yuxuan-518/piezoelectric-floor-tile/docs/process-reports/README.md

# Process summaries and laboratory reports

These Chinese documents record the team's development process. They include exploratory explanations, simulation notes, and proposed tests as well as experimental observations. A proposed test in a report is not evidence that it was completed.

The [current experiment definitions](../experiments.md) incorporate the team's November 4 clarifications: A is the one-disc adaptation of V1, B is V3, and the A/B storage capacitor is 4.7 μF. Older eight-disc V1 and 2.2 μF configurations remain historical records.

| Document | Scope |
| --- | --- |
| [Design iterations, October 31](design-iterations-2026-10-31.pdf) | 31-page project overview with V1–V3 development, measurements, simulation discussion, and unresolved items at that date |
| [Circuit troubleshooting, June 1](circuit-failure-and-troubleshooting-2026-06-01.docx) | Unlit LED, candidate causes, and a proposed diagnostic sequence |
| [Bridge continuity and LED trials, June 2](bridge-continuity-and-led-trials-2026-06-02.md) | Soldered bridge continuity and unsuccessful breadboard LED attempt |
| [Bridge and parallel wiring, June 4](bridge-and-fourteen-disc-wiring-2026-06-04.pdf) | Five bridges, fourteen-disc wiring, and connection problems; not quantitative output data |
| [Capacitor and LED tests, June 12](node-voltage-capacitor-and-led-tests-2026-06-12.pdf) | Node-voltage measurements and capacitor comparison during circuit replication |
| [V2 candidate selection](v2-simulation-candidate-selection-2026-07-02.md) | Reading simulated event classifications and mass/stiffness candidates |
| [V2 modeling review](v2-modeling-and-data-processing-review-2026-07-02.md) | Event-driven mechanics, measured displacement input, preprocessing, and boundary corrections |
| [V2 spring specifications](v2-spring-procurement-specifications.txt) | Procurement targets and tolerances, rather than measured spring rates |
| [V2 model and experiment plan](v2-theory-comparison-and-measurement-plan-2026-08-01.docx) | Eight-module model, continuous-contact baseline proposal, capacitor measurement and statistical plan |
| [V3 contact-force method](v3-center-punch-contact-force-method.pdf) | Method to estimate peak contact force from contact speed, effective mass and stiffness; not a measured force result |
| [Reference links](reference-paper-and-lab-log-links.txt) | Reference paper and online laboratory-log link |

The V3 force PDF appeared twice under different source filenames with identical bytes; one copy is included. File contents are retained. Historical Markdown reports can contain local figure paths from the original working environment; the relevant current V2 plots are available in [simulation/v2/figures/](../../simulation/v2/figures/).
