yuxuan-518/piezoelectric-floor-tile/assets/images/README.md

# Images

| Folder | Contents |
| --- | --- |
| [v1/](v1/) | Initial glue-contact replication and revised eight-disc sponge sandwich |
| [v2/](v2/) | Concept sketch, CAD geometry, structural-analysis setup, and assembled tile |
| [v3/](v3/) | Assembled V3 prototype, printed components and springs, center-punch section drawing, and animation preview |
| [equipment/](equipment/) | Camera selection reference, separate from prototype images |
| [../figures/](../figures/) | A/B measurement figures generated from the displayed-value snapshot |

A V2 assembled-tile photo originally outside the V2 subfolder is grouped here with the second version. The V1 eight-disc photos illustrate the historical tile, not the later one-disc A comparator. V3 includes physical photographs of the assembled prototype, printed components, and springs, together with a separate mechanism drawing.

## V3 physical photographs

- [IMG_7800](v3/IMG_7800.jpg): component photograph displayed below the experiment videos at the front of the main README.
- [IMG_7799](v3/IMG_7799.jpg): components laid out, displayed in the bottom V3 gallery.
- [IMG_7801](v3/IMG_7801.jpg): components and springs, displayed in the bottom V3 gallery.
- [Assembled prototype, view 1](v3/assembled-1.jpg): placed before IMG_7800 near the front of the main README; source: 组装后1.HEIC.
- [Assembled prototype, view 2](v3/assembled-2.jpg): displayed at the end of the V3 gallery in the main README; source: 组装后2.HEIC.
