yuxuan-518/piezoelectric-floor-tile/assets/videos/README.md

# Videos

| File | What it shows |
| --- | --- |
| [Open-circuit test — 5 presses (IMG_7791)](https://github.com/user-attachments/assets/d7630d02-6c3a-4639-a595-0fe88d64db57) | Manual actuation with the open-circuit voltage waveform shown on the oscilloscope |
| [4.7 μF capacitor test — 10 presses (IMG_7792)](https://github.com/user-attachments/assets/3c00106a-591d-475d-8370-14c3a34ea7ed) | Manual actuation with a 4.7 μF capacitor connected |
| [Phase 0 LED demonstration](phase0-piezo-led-demonstration.mp4) | Tapping piezoelectric discs to light an LED during circuit replication |
| [V2 Fusion static analysis](v2-fusion-static-analysis.mp4) | Center-loaded structural simulation; [WEBM alternative](v2-fusion-static-analysis.webm) |
| [V2 floor-displacement simulation](v2-floor-displacement-simulation.mp4) | Simulation video identified by the team as the second design |
| [V3 center-punch mechanism](v3-center-punch-mechanism.mp4) | Animation of energy storage, trigger alignment, and release |
| [V3 center-punch cutaway](https://github.com/user-attachments/assets/8360fb55-114a-463f-ac32-afa692dda5be) | Additional cutaway animation of the center-punch mechanism; [repository copy](v3-center-punch-cutaway.mp4) |

The simulation and mechanism videos illustrate designs rather than instrumented physical test results. Original experimental displacement and capacitor videos are packaged with the [historical data release](https://github.com/yuxuan-518/piezoelectric-floor-tile/releases/download/project-archive-2026-11-04/historical-v1-v2-measurements.zip).

No V1 mechanism/CAD animation was supplied; V1 is documented with photos and laboratory records.
