yuxuan-518/piezoelectric-floor-tile/docs/process-reports/bridge-continuity-and-led-trials-2026-06-02.md

# 6.2 原型电路复刻实验报告

目标

* 4个1n60p 二极管桥式整流电路  
* 电容储能  
* 尝试驱动黄色LED

材料清单：

| 压电陶瓷片 | 未使用 |  |
| :---- | :---- | :---- |
| 1N60P 二极管x4 | 使用 | 通过电焊组成整流桥并且通过了万用表测试。 |
| 100uF / 25V 电解电容  | no |  |
| 150 ohm 电阻 | no |  |
| 黄色LED | no |  |
|  |  |  |
| 电焊器组 | 使用 |  |
| 万用表 | 使用 |  |

实验结果：进行中  
Team A \-  xsx ysq

* 通过电焊组成整流桥   
  * 已通过万用表测试  
* 学习了关于整流桥的基本电路原理

Team B \- whj

* 用其他论文中的相似电路用面包板实现电路工作点亮LED-失败 	— 行不通  
* 学习相关电子元件的作用，了解现有整流桥的电子流向

下次实验方向

* 完成整流桥，电容，压电片，形成完整电路  
* 尝试点亮LED  
* 明白其电路图的工作原理
