yuxuan-518/piezoelectric-floor-tile/docs/process-reports/reference-paper-and-lab-log-links.txt

Selim, K.K., Yehia, H.M., & Saleeb, D.A. (2024). Energy Harvesting Floor Tile Using Piezoelectric Patches for Low-Power Applications. Journal of Vibration Engineering & Technologies, 12, 8613-8622. https://doi.org/10.1007/s42417-024-01379-z
Online lab report (June 2): https://docs.google.com/document/d/1Qe5F5qePgIK7pGi6XQBFLI0McOi2MfYt_HB0X1i6unA
