yuxuan-518/piezoelectric-floor-tile/CREDITS.md

# Contributors

This project was developed by Shaoxuan Xiong, Shuoqi Yang, and Wenhao Jia. The original contributions were clarified on November 5, 2026; all three contributor descriptions were revised on November 8, 2026. **Shaoxuan Xiong led the research and is the first author of the project manuscript.**

<table>
<tr><td>
<h2>Shaoxuan Xiong</h2>
<ul>
<li>As the first author of the project manuscript and research lead, I led the development of the research idea, workflow, and methods, and coordinated the project's experimental and analytical work.</li>
<li>I was responsible for early circuit assembly, capacitor selection, and V1/V2 measurements, assessed data quality and the plausibility of the results, and led the overall data analysis.</li>
<li>During V2 development, I led mechanism development, Python simulation, and spring-parameter selection, and revised and checked the physical model assembled by Shuoqi Yang.</li>
<li>During the V3 stage, I reviewed the data independently collected by Wenhao Jia and Shuoqi Yang and completed all data analysis and figure preparation.</li>
<li>For the manuscript, I established the overall structure and line of argument, then revised, integrated, and refined the initial draft to produce the final manuscript.</li>
</ul>
</td></tr>
</table>

<table>
<tr><td>
<h2>Shuoqi Yang</h2>
<ul>
<li>Participated in measuring, recording, and transcribing V2 and V3 experimental data, and analyzed the V2 data by organizing the measurements and comparing output across tests to support subsequent structural revisions and discussion of the results.</li>
<li>For the V2 motion study, measured and transcribed the displacement of the upper wooden plate driven by footsteps, providing measured motion inputs for simulation.</li>
<li>Was responsible for CAD modeling of V2 modular components, representing the mechanical parts and their structural relationships for assembly and design discussions.</li>
<li>In the V3 stage, led the organization of the physical formulas, including the quantities and relationships used to analyze mechanism motion and contact forces.</li>
<li>Also carried out circuit connection and soldering to support prototype construction and experimental measurements.</li>
</ul>
</td></tr>
</table>

<table>
<tr><td>
<h2>Wenhao Jia</h2>
<ul>
<li>Wrote the first manuscript draft according to the established outline, organizing the design evolution, experimental methods, and research results into initial sections for subsequent discussion and revision.</li>
<li>Participated in measuring and recording V2 and V3 experimental data and assisted with transcription.</li>
<li>For the V2 motion study, recorded and transcribed displacement measurements of the upper wooden plate driven by footsteps to support subsequent data processing and simulation.</li>
<li>Was responsible for V2 CAD assembly modeling, bringing the component models together into a complete assembly, and produced force-analysis animations to illustrate structural relationships and loading.</li>
<li>In the V3 stage, participated in collaborative mechanism design and carried out the related CAD modeling and motion-animation work to illustrate the mechanism's motion and triggered release.</li>
</ul>
</td></tr>
</table>

## Prototype reference

The mechanical starting point was the prototype in Selim, Yehia and Saleeb (2024), [doi:10.1007/s42417-024-01379-z](https://doi.org/10.1007/s42417-024-01379-z). The sponge interface, subsequent mechanisms, and experiments in this repository document this team's development from that starting point.
