yuxuan-518/piezoelectric-floor-tile/assets/images/v3/center-punch-cutaway-preview.png

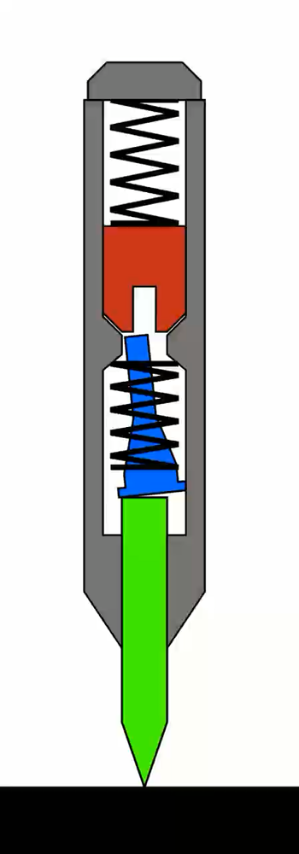
assets/images/v3/center-punch-cutaway-preview.png
