yuxuan-518/piezoelectric-floor-tile/cad/v3/center-punch-assembly.stl

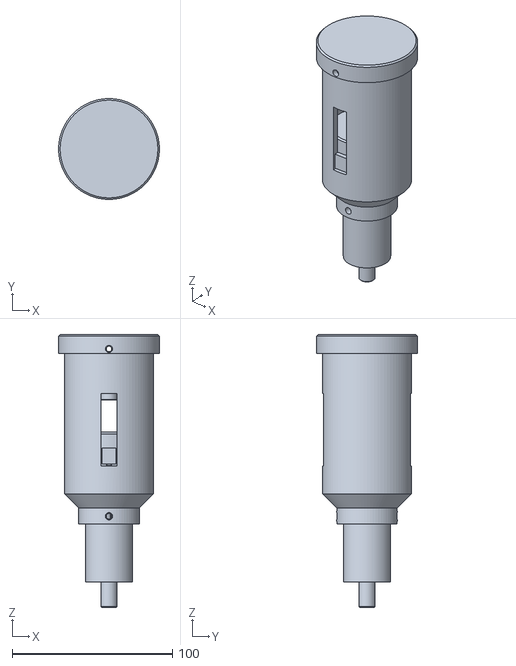
[picture p40: CAD file, 2026-11-05]
cad/v3/center-punch-assembly.stl
63.0 x 63.0 x 170.5
