yuxuan-518/piezoelectric-floor-tile/cad/components/impactor.stl

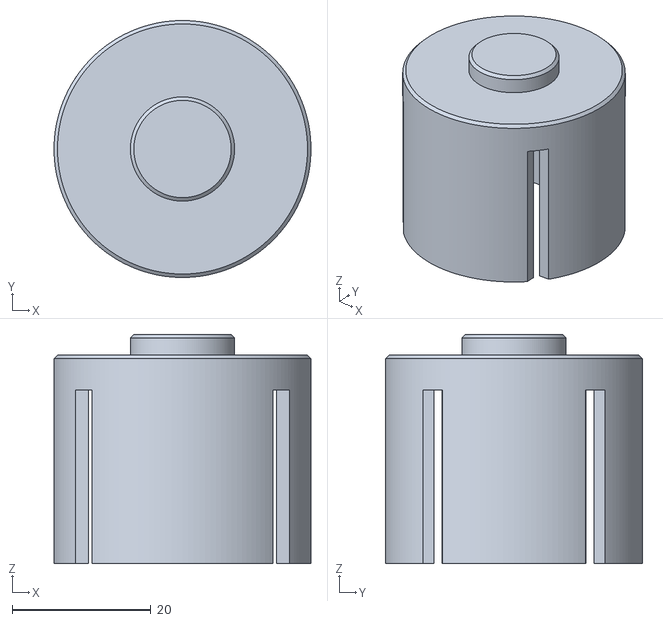
[picture p41: CAD file, 2026-11-05]
cad/components/impactor.stl
37.0 x 37.0 x 33.0
