yuxuan-518/piezoelectric-floor-tile/docs/process-reports/bridge-and-fourteen-disc-wiring-2026-06-04.pdf

# 发电地板项目实验报告

日期：2026年6月4日
实验人员：熊少轩，杨烁琪，贾文浩（排名不分先后）

今日项目进度：
- 焊接完成了5个整流桥
- 整理了压电片部分内容，将14个压电片并联并，通过万用表检验发现电路完善 ，各个部分正常通电

项目问题：
- 由于并没有对数据进行分析仅仅测试电路是否流通，所以未判断增加被施加力 的压电片数量是否会按照理论实现电流增大
- 电焊技术不到位，有些地方的连接不稳定，会出现压电片和主干电线的连接断 开（直接断开或通电异常）的情况
- 未记录任何实验数据

明日计划：
- 完成六个不同的整流桥和电容连接方式（1）
- 将压电发电部分改成灵活拆卸的样式（2）
- 分别调试（1）和（2），确认正常之后连接看整体是否正常输出电流
