yuxuan-518/piezoelectric-floor-tile/docs/experiments.md

# A/B measurements

## Structures and circuit

| Item | Confirmed condition |
| --- | --- |
| A | V1-derived sponge structure with one piezoelectric disc |
| B | V3 center-punch structure, using one disc for the count-matched comparison |
| Historical V1 tile | Eight parallel discs; a different configuration from A |
| Quasi-open-circuit measurement | Before rectification, using the oscilloscope input |
| Capacitor | 4.7 μF for the current A/B experiment |
| Single-step initial state | Capacitor discharged before each step; recorded V0 values are zero at displayed precision |
| Attenuation | Matching oscilloscope/probe settings confirmed by the team |

The oscilloscope presents a finite input impedance, hence the retained term **quasi-open-circuit**. Voltage measurements under this condition are not delivered load energy.

## Stepping protocol and comparison limits

The team confirmed the following conditions on November 5, 2026:

| Condition | Recorded protocol |
| --- | --- |
| Operator, footwear, and stepping location | Same person, same shoes, and a fixed stepping location for A/B |
| Input motion | Normal stepping; displacement/travel and stepping speed or cadence were neither controlled nor recorded |
| Test order | A/B alternation; no randomization is claimed |
| Piezoelectric disc model | Same model for A/B; exact specification is not recorded in this snapshot |
| Rectifier bridge | Same bridge for A/B; exact specification is not recorded in this snapshot |
| Readout timing | Same post-step waiting time for A/B; its numerical duration is not recorded in this snapshot |

Alternating order, a shared operator, matching component types, and matching readout delay reduce some procedural differences, but do not establish equal force, displacement, or mechanical work at each step. The results describe capacitor storage in these normal-stepping tests. They do not isolate mechanism-only effects or establish an electrical conversion-efficiency gain. Readout timing matters because stored voltage can decay after a step.

For a future controlled comparison, record force and displacement together to estimate input work, specify the post-step readout delay, and record the disc and rectifier specifications. Keep those future measurements separate from this existing dataset. Alternation alone does not establish paired observations: the copied worksheet has no event log linking specific A and B steps.

## Stored-energy calculation

For each trial:

\[
\Delta E_C = \frac{1}{2}C\left(V_1^2 - V_0^2\right).
\]

With C = 4.7 μF and voltage in volts, ΔE in μJ equals `2.35 * (V1**2 - V0**2)`. This is the net increase in capacitor energy over the measurement window. It is not the total mechanical energy supplied or all electrical energy generated by the disc.

The copied voltage display for the single-step sheet has one decimal place. The workbook's recorded energy can have been calculated from more precise cell values. Re-squaring the rounded voltage can therefore disagree with its recorded energy. The repository keeps both displayed quantities and calculates descriptive summaries from the **recorded energy** column. It verifies that these energy values fit within the voltage-rounding intervals for a 4.7 μF capacitor.

## Snapshot and sample counts

The [live workbook](https://1drv.ms/x/c/ec731eaab7075a35/IQBu0pYTxfz4QIeSvFwY5F9VATk93ZKyLGgmgde4zelluMU) was read on **November 4, 2026** using the read-only Copy command in Excel Online. The local JSON and CSV files are snapshots of formatted displayed values, not a complete XLSX download, formula export, or full-precision instrument export.

| Sheet | Imported region | Interpretation |
| --- | --- | --- |
| 准开路 | A1:J21 and A24:J44 | A and B, three column groups of 20 steps each |
| 单次电容 | A1:P23 and A24:P46 | A and B, five adjacent V0/V1/Ec groups of 20 steps each |
| 多次电容_5 | A1:H12 | Five charging runs per structure, five steps per run |
| 多次电容_10 | A1:H12 | Five charging runs per structure, ten steps per run |
| 多次电容_20 | A1:H12 | Five charging runs per structure, twenty steps per run |

The unlabelled flattened columns on the right of the single-step sheet are not imported as extra trials. Group/trial indices preserve the worksheet organization; matching row numbers are not assumed to establish statistically paired A/B trials.

## Difference from the older summary

The “条件” sheet still describes three groups and contains earlier single-step summary values. Its A energy means (roughly 2.3–2.5 μJ) differ from the current labeled single-step blocks (roughly 10–13 μJ per group). Its B values also differ from the expanded current blocks. Consequently, its earlier improvement figures are not used as current results.

The repository's [summary.csv](../data/ab-comparison/summary.csv) is recomputed from the current labeled blocks. It gives approximately **11.6 μJ for A and 72.5 μJ for B**, with a ratio of means around **6.23**. This is a descriptive comparison of the stored-energy records. The chart shows sample SD rather than confidence intervals. Repeated steps from one person are not independent participants; test order alternated and mechanical input work was not measured.

The [formula review workbook](../data/ab-comparison/ab-formula-review-2026-11-05.xlsx) supplies current summary formulas and a separate calculation from rounded voltage, including its rounding interval. It is derived from the November 4 displayed-value snapshots. It does not preserve the live workbook's original formulas or hidden precision, and does not replace an original XLSX archive. The older online “条件” sheet has not been edited.

The condition sheet mentions 50-step charging and a 150-cycle durability test. No separate populated records for those tests were identified in the six available sheets, so those tests are not presented as completed results.

## Historical records

The historical release archive contains the separately documented eight-disc V1 and V2-era oscilloscope images, capacitor recordings, and motion videos. Older reports discuss a 2.2 μF circuit; that historical value is not substituted for the confirmed 4.7 μF A/B capacitor. Original V1 images show an X10 scope setting and V2 images X1; the archived notes preserve this distinction.

The team confirmed that A/B attenuation settings match. This does not identify the exact circuitry or sensor count in every older historical image. Historical shots are therefore not silently merged into the A/B dataset.
