yuxuan-518/piezoelectric-floor-tile/simulation/v2/results/measured_v3_paper_candidates.csv

# generated_at: 2026-07-02 21:46:52
# source: measured_v3_sim_sweep.csv preprocess=clamp 子集
# strong_candidate: max_rel_speed_ms >= 0.5
# moderate_candidate: 0.1 <= v < 0.5
# borderline_candidate: 0.05 <= v < 0.1
# below_threshold: v < 0.05（有效但不纳入主结论）
# time_precision_note: 100Hz 数据，Δt=10ms，样条插值。
# detach_time_s 的 1e-7 精度是数学精度，非物理精度（物理精度≤5ms）。
# 论文引用请用 detach_time_paper_s（精确到 1ms），并注明'约 XXX ms'。
# note: recommended 字段来自参数化模型语境，在此仅作参考，不作论文依据。
trial | preprocess | smooth | m_g | k_Nmm | k_Nm | e | T_up_crit_ms | detach | detach_time_s | N_at_detach | impact_count | impact_times_s | max_rel_speed_ms | max_impact_energy_mJ | risky | recommended | data_end_s | detach_margin_to_end_s | is_tail_detach_20ms | is_early_detach_20ms | is_valid_detach_for_paper | n_clamped_pts | candidate_grade | detach_time_paper_s
fast_3 | clamp | none | 100 | 0.5 | 500 | 0.5 | 31.4 | True | 0.285531 | 0.0 | 2 | [0.3039177, 0.3544288] | 1.16857 | 68.27779 | False | True | 0.32 | 0.03447 | False | False | True | 2 | strong | 0.28600000000000003
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
