yuxuan-518/piezoelectric-floor-tile/simulation/v2/results/measured_v3_sim_sweep.csv

# version: measured_v3
# generated_at: 2026-07-02 21:45:48
# e_fixed: 0.5
# smooth_savgol: window=5 polyorder=2
# smooth_butter: cutoff_hz=10 order=2
# t_end_sim: 1.0s
# preprocess_raw: 保留原始数据（含末尾负值）
# preprocess_clamp: 峰后首次 y<=0 起截为 0
# boundary_fix_v2: t>t_max → y=last | v=0 | a=0
# is_tail_detach_20ms: detach_time_s > data_end_s - 0.02s
# is_early_detach_20ms: detach_time_s < data_start_s + 0.02s
# is_valid_detach_for_paper: detach AND NOT tail AND NOT early AND impact_count>0
# 论文主结论：preprocess=clamp + is_valid_detach_for_paper=True
# 敏感性附录：preprocess=raw 对比
trial | preprocess | smooth | m_g | k_Nmm | k_Nm | e | T_up_crit_ms | detach | detach_time_s | N_at_detach | impact_count | impact_times_s | max_rel_speed_ms | max_impact_energy_mJ | risky | recommended | data_end_s | detach_margin_to_end_s | is_tail_detach_20ms | is_early_detach_20ms | is_valid_detach_for_paper | n_clamped_pts
fast_1 | raw | none | 50 | 0.5 | 500 | 0.5 | 22.2 | False |  |  | 0 | [] | 0.0 | 0.0 | False | False | 0.32 |  | False | False | False | 0
fast_1 | raw | none | 50 | 1.0 | 1000 | 0.5 | 15.7 | False |  |  | 0 | [] | 0.0 | 0.0 | False | False | 0.32 |  | False | False | False | 0
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
