yuxuan-518/piezoelectric-floor-tile/docs/process-reports/v2-theory-comparison-and-measurement-plan-2026-08-01.docx

压电地板弹簧-撞击能量采集系统

理论模型、能量转换流程、对比实验与数据测量计算完整报告

研究对象 | 8模块弹簧-撞击式压电能量采集地板
核心问题 | 多次分离-再撞击是否提高单次踩踏净电容储能
报告性质 | 降复杂度、保执行性；实验主导的降阶工程模型
版本日期 | 2026-08-01

核心证据链

板位移 → 弹簧压缩与储能 → 分离/再撞击 → 多个压电脉冲 → 整流 → 电容净储能提升

说明：本报告不把简化模型包装成完整有限元或高保真碰撞仿真。最终性能结论以同步视频、开路波形和电容储能实测为准。

# 1. 报告目的与最终研究问题

本报告把已经确认的实际结构、分段机械模型、电学转换链路、Baseline对比方案、需要直接测量的数据、需要由实测数据计算的量、统计分析以及减少压电片消耗的执行安排统一到一份可直接用于实验和正式技术报告的方案中。

研究问题：New结构中的弹簧-撞击物分离与多次再撞击，是否在相近踩踏条件下，比Baseline产生更多可利用电能？

## 1.1 最主要的结果指标

ΔE_step = 1/2 · C_F · (V_after² - V_before²)

该量应命名为“单次踩踏净电容储能增量”。它不是压电片产生的全部机械-电能，而是经过压电内部损耗、整流桥损耗、导线损耗和电容漏电后，最终留在储能电容中的净增量。New与Baseline使用完全相同电路时，该指标最适合公平对比。

# 2. 已确认的装置结构与建模边界

## 2.1 上板与压电组件

- 上层亚克力板尺寸为455 mm × 610 mm × 2 mm，踩踏位置位于板中心附近。
- 压电片安装在亚克力板下表面，不在装置底部。
- 单个压电模块自上而下依次为：亚克力板下表面、上层海绵、压电陶瓷面、黄铜面、下层海绵、撞击物顶部突起、撞击物、大弹簧、底部支撑/孔结构。
- 压电片边缘以电工胶带在两侧固定于亚克力板下表面，主要工作形式为弯曲。
- 系统共有8个主压电-撞击模块，8片压电片先并联，再接共同的整流桥和2.2 μF储能电容。

## 2.2 主弹簧-撞击模块

- 撞击物位于大弹簧上端，顶部突起朝向下层海绵和压电片。
- 大弹簧没有粘死或机械锁死，只是放置在相应孔内。
- 主模块及其导向孔/导向结构位于四层EPS泡沫中。导向管不应被描述为包裹撞击物，除非实物几何另有确认。
- 设计初始状态为撞击物突起与下层海绵刚好接触：设计间隙g₀=0，且没有额外人为预压。装配后仍需逐模块实测确认。
- 模型中只有在视频确认弹簧底端不离底、不明显滑动且底部支撑位移很小时，才将底端近似视为固定端。

## 2.3 四角限位/回位系统

- 亚克力板四角各有一套限位弹簧和限位导向管。
- 限位弹簧上端粘接在亚克力板四角。
- 限位系统位于上面三层EPS泡沫中；主模块位于四层泡沫中。
- 限位系统限制最大下压行程并帮助上板回升。约25 mm目前应区分为设计值或实测值，正式报告以实测y_max为准。

# 3. 从脚部压力到最终电压的完整流程

1. 脚在亚克力板中心附近施加载荷，上板产生整体下降和局部弯曲。
2. 亚克力板下表面的上层海绵-压电片-下层海绵组件随板向下运动。
3. 下层海绵压到撞击物突起，撞击物向下运动，大弹簧被压缩并储存弹性势能。
4. 压电片在第一次快速加载中弯曲，产生第一组正负电荷/电压脉冲。
5. 脚开始卸载，上板在四角回位结构和自身弹性作用下回升；接触力逐渐减小。
6. 当维持接触所需的法向力降为零后，撞击物与上方组件发生分离。
7. 分离后，撞击物-大弹簧系统进行近似阻尼自由振动。
8. 撞击物向上追上回升的上方组件，重新接触下层海绵并再次弯曲压电片，形成后续电压脉冲。
9. 若剩余机械能足够，分离-再接触可重复多次，脉冲幅值通常逐渐衰减。
10. 8片压电片并联后的交流脉冲经过桥式整流后变为同方向充电电流。
11. 只有足够高的瞬时压电阵列电压才能克服当时的电容电压和二极管压降，使储能电容产生可测的正向电压台阶。
12. 由踩踏前后电容电压平方差计算单次踩踏净电容储能增量。

# 4. 机械模型与公式

统一约定向下为正。对第i个模块，y_p,i为亚克力板/上方压电组件局部位移，y_m,i为撞击物位移，y_b,i为弹簧底端支撑位移。

## 4.1 弹簧压缩量

Δx_i(t) = y_m,i(t) - y_b,i(t)

若底端支撑位移可忽略，则Δx_i≈y_m,i。只有在撞击物与上方组件保持接触、海绵及压电组件相对变形较小、弹簧底端近似静止时，才进一步近似：

Δx_i(t) ≈ y_p,i(t) （仅限接触阶段）

脱离后不得继续使用Δx≈y_p，必须由撞击物自身位移确定弹簧压缩量。

## 4.2 弹簧力与储能

F_s(t) = k · Δx(t)

E_s,max = 1/2 · k · [Δx_max]²

k必须通过独立静态加载试验获得，不能由压电电压反推。E_s,max表示最大压缩时储存在主弹簧中的理论弹性能，不等于最终电能。

## 4.3 间隙、接触与分离

g_i(t) = g_0,i + Δy_m,i(t) - Δy_p,i(t)

- g_i>0：存在间隙，撞击物与上方组件分离。
- g_i=0：刚好接触。
- 理想刚性接触模型不允许g_i<0；若考虑海绵柔性，可定义接触压缩量δ_i=max(0,-g_i)。
- 再接触事件除g_i=0外，还应满足间隙正在闭合，即ġ_i<0。
- 自由振动不是从“松脚瞬间”立即开始，而是从接触法向力N降到0并发生分离之后开始。

## 4.4 分离后的阻尼自由振动

m_eq · z¨ + c · z˙ + k · z = 0

ω_n = √(k / m_eq)

ω_d = ω_n · √(1 - ζ²), T_d = 2π / ω_d

m_eq,exp = k · (1 - ζ²) · (T_d / 2π)²

若实测阻尼比ζ足够小，才可用简化式m_eq,exp≈k(T_d/2π)²。

## 4.5 理论等效质量与校核

m_eq,theory ≈ m_impactor + (1/3) · m_spring

该1/3修正适用于一端近似固定、一端随质量块运动的均匀弹簧。由于实际大弹簧未粘死，必须先通过视频确认其底端不明显离底或滑移。

ε_m = |m_eq,exp - m_eq,theory| / m_eq,exp × 100%

两种估计方法应互相校核，而不是只选一个结果。差异过大时，应检查底端运动、导向摩擦、泡沫支撑变形、周期识别和弹簧非线性。

## 4.6 阻尼比的实测估计

Λ = ln(A_1 / A_2)

ζ = Λ / √(4π² + Λ²)

A₁和A₂应为相邻同方向振动峰值。可对多对峰值分别计算后取平均，降低视频读数误差。

## 4.7 再撞击速度与辅助强度指标

v_p = dy_p/dt, v_m = dy_m/dt

v_rel = |v_m - v_p|

E_impact,index = 1/2 · m_eq · v_rel²

该式仅作为“简化撞击强度指标”，不能称为精确传入压电片的能量，因为上板局部质量、海绵压缩、接触面积和碰撞损失均未完全建模。位移求导前必须先平滑，不能直接对原始视频坐标做简单差分。

# 5. 压电与电路模型

## 5.1 结构级压电关系

Q_i(t) = d_eff,i · F_i(t)

I_i(t) = dQ_i(t)/dt

d_eff是整个压电片-海绵-胶带-边界约束的等效系数。由于压电片主要弯曲，不能直接把材料手册中的d₃₃或d₃₁代入来精确预测电压。没有独立已知力标定时，这两式只用于解释动态载荷如何产生电荷和电流脉冲。

## 5.2 单片与8片并联

单片等效：电流源 I_s,i 与 C_p,i、R_p,i 并联

I_Σ(t) = Σ I_i(t), C_Σ = Σ C_p,i, 1/R_Σ = Σ(1/R_p,i)

并联主要提高可提供的总电荷/电流能力，不是简单把电压放大8倍。若各压电片波形不同步，某些时刻可能发生部分抵消，因此应抽查单片波形与极性。

## 5.3 开路电压

V_oc,i ≈ Q_i / C_p,i ≈ d_eff,i · F_i / C_p,i

该关系可用于趋势解释。开路峰值高不等于实际可储存能量高，因此开路测试只能作为机械机制和多脉冲证据，不能替代储能或负载测试。

## 5.4 整流桥与储能电容

理论瞬时导通条件：|V_P(t)| > V_C(t) + 2V_D

该条件只用于解释整流桥何时导通。V_C随充电过程变化，V_D也随电流变化，所以它不作为实验中“有效峰”的最终计数判据。

C_F · dV_C/dt = I_rect(t) - I_loss(t)

E_C = 1/2 · C_F · V_C²

ΔE_step = 1/2 · C_F · (V_after² - V_before²)

## 5.5 有效充电脉冲定义

ΔV_C,j* = V̄_C,after - V̄_C,before - ΔV_C,drift

若 ΔV_C,j* > max(3σ_VC,noise, ΔV_scope)，则记为1个有效充电脉冲

- 候选台阶前后应使用短时间窗口平均值，而不是单个采样点。
- 同一连续电容台阶内的多个高频振荡合并为一个有效充电脉冲。
- 机械撞击次数N_impact与有效充电脉冲数N_charge必须分开报告，两者不相等是正常结果。

# 6. New与Baseline对比实验设计

## 6.1 New结构

保留大弹簧-撞击物在卸载后的分离、独立振动和多次再撞击机制。

## 6.2 Primary Baseline

采用连续接触控制结构：使用尽可能小的轻预载或柔性保持件，使撞击物在上板回升时仍与下层海绵保持接触，从而显著减少或消除“分离-自由振动-再撞击”，但尽量保留第一次踩下的传力路径。

- New与Baseline必须使用同一块亚克力板、同样8片压电片和位置、相同海绵、胶带、整流桥、储能电容、踩踏位置和测量系统。
- Baseline不得简单拆掉大弹簧、撞击物或换成完全不同的传力柱，否则会同时改变刚度、接触面积和第一次加载。
- 保持件或限位件不得在正常踩踏中形成新的猛烈碰撞。

## 6.3 Baseline附加噪声验证

|ΔV_C,fixture| / |ΔV_C,main| < 5%

|ΔV_C,fixture| ≤ max(3σ_VC,noise, ΔV_scope)

S_main统一采用电容电压增量ΔV_C，不再使用含义模糊的综合信号量。5%是预先规定的工程容许标准，不是普遍物理常数。若保持机构单独产生的电容台阶超过上述判据，应重新固定、减小预载、消除松动或更换柔性约束。

# 7. 需要直接测量的数据

## 7.1 不通过踩踏测量的一次性参数

数据 | 测量方式 | 用途
亚克力板长/宽/厚 | 卡尺或卷尺 | 结构说明；确认实际尺寸
4层EPS厚度及底板厚度 | 卡尺 | 结构与行程边界
主模块/限位导向管尺寸与层位 | 卡尺+实物检查 | 结构说明
大弹簧自由长度、外径、线径、圈数、质量 | 卡尺+电子秤 | 弹簧描述与理论等效质量
撞击物质量、突起直径与偏心量 | 电子秤+卡尺 | 动力学与接触几何
上下海绵尺寸和厚度 | 卡尺 | 接触柔性与装配公差
8片压电片尺寸与每片电容C_p,i | 卡尺+LCR表 | 一致性与并联模型
8片并联总电容C_Σ | LCR表 | 检查C_Σ≈ΣC_p,i
储能电容实际值C_F | LCR表/电容表，至少3次 | 储能公式使用实测值
二极管型号与典型压降 | 数据表+可选实测 | 整流说明
主大弹簧刚度k | 多个已知载荷与位移 | 机械模型核心参数
4根限位弹簧刚度 | 逐根静态加载 | 回位系统一致性

## 7.2 需要实际踩踏/会消耗压电片疲劳寿命的数据

数据 | 符号 | 测量方式 | 主要用途
上板局部位移曲线 | y_p(t) | 同步侧视视频 | 机械输入与踩踏一致性
撞击物位移曲线 | y_m(t) | 代表模块高速/高帧率视频 | 分离、再接触、周期、速度
最大下压位移 | y_max | 视频标尺 | 确保New与Baseline踩踏深度相近
踩下/回升时间 | T_down, T_up | 视频 | 动作速度控制
机械总接触/撞击数 | N_impact | 视频 | 机械机制结果
再撞击数 | N_reimpact | 视频；定义是否含第一次加载 | 证明多次再撞击
阻尼振动周期 | T_d | 多个同方向峰值时刻 | 反推m_eq
相邻峰幅值 | A_1,A_2,... | 视频 | 估计ζ
整流前开路正负峰值 | V_peak+, V_peak- | 8片并联→示波器高阻输入 | 原始脉冲机制
整流前脉冲数与持续时间 | N_peak,T_signal | 开路波形 | 验证后续脉冲
踩踏前电容电压 | V_before | 整流桥+电容+示波器 | 单次净储能
踩踏后电容电压 | V_after | 整流桥+电容+示波器 | 单次净储能
有效充电脉冲数 | N_charge | 电容电压台阶 | 可利用脉冲数
连续踩踏初末电压 | V_initial,V_final | 固定节奏连续踩踏 | 净功率
LED点亮踩踏次数/时间（可选） | N_LED,T_LED | 应用演示 | 仅展示，不作主指标

## 7.3 无需踩踏但必须记录的噪声与漂移

- 静止状态下电容通道噪声：至少记录10 s，计算σ_VC,noise。
- 与单次实验相同时间窗口的电容静置漂移：至少5次，得到ΔV_C,drift。
- 示波器当前量程和采样设置下的有效分辨率ΔV_scope。
- Baseline保持机构的低幅/空载附加电容增量ΔV_C,fixture。

# 8. 需要由测量数据计算的量

计算量 | 公式/方法 | 定位
弹簧压缩增量 | Δx=y_m-y_b；接触阶段条件满足时Δx≈y_p | 机械输入
弹簧力 | F_s=kΔx | 力水平
最大弹簧储能 | E_s,max=1/2·k·Δx_max² | 理论机械能
振动频率 | f_d=1/T_d | 动态特征
阻尼比 | ζ=Λ/√(4π²+Λ²), Λ=ln(A₁/A₂) | 判断简化公式适用性
实验等效质量 | m_eq,exp=k(1-ζ²)(T_d/2π)² | 动力学参数
理论等效质量 | m_eq,theory≈m_impactor+(1/3)m_spring | 初始估计
两种质量相对差异 | ε_m=|m_exp-m_theory|/m_exp×100% | 模型校核
上板/撞击物速度 | v_p=dy_p/dt, v_m=dy_m/dt | 再撞击运动
再撞击相对速度 | v_rel=|v_m-v_p| | 撞击强弱
简化撞击强度指标 | E_impact,index=1/2·m_eq·v_rel² | 辅助趋势，不作精确能量
修正电容台阶 | ΔV_C*=V̄_after-V̄_before-ΔV_drift | 有效脉冲判定
单次净电容储能 | ΔE=1/2·C_F(V_after²-V_before²) | 主结果
连续测试净能量 | ΔE_total=1/2·C_F(V_final²-V_initial²) | 连续性能
连续净功率 | P_net=ΔE_total/T_test | 连续性能
固定电阻负载能量（可选） | E_L=∫V_L²/R_L dt | 实际交付能量
均值与标准差 | x̄, s | 重复性
平均提升率 | η_E=(Ē_New-Ē_Base)/Ē_Base×100% | 工程效果
配对差 | d_j=ΔE_New,j-ΔE_Base,j | 统计检验输入
配对t统计量 | t=d̄/(s_d/√n), df=n-1 | 显著性
95%置信区间 | d̄±t_0.975,n-1·s_d/√n | 效果范围

# 9. 电路测试工况与优先级

工况 | 连接 | 回答的问题 | 优先级
A. 开路波形 | 8片并联→示波器高阻输入 | 证明多次撞击产生多个原始脉冲 | 必须；New/Base各约5次
B. 整流桥+2.2 μF电容 | 8片并联→桥式整流→储能电容 | 计算单次净储能；主结论 | 最高优先级
C. 固定电阻负载 | 整流后接已知R_L并测V_L(t) | 实际向负载交付能量 | 强烈建议但可后做
D. LED演示 | 整流+电容+LED/限流电阻 | 直观应用展示 | 少量演示，不作主定量
E. 倍压电路 | 相同机械结构下统一倍压电路 | 研究电路拓扑 | 非本研究最低必做

原论文测试了桥式整流和倍压电路下的开路、单LED、双LED串/并联等工况。你们不需要机械式照搬全部工况；主研究变量是机械多次撞击，因此必须把实验资源优先用于New与Baseline在同一电路下的公平比较。

# 10. 预实验、样本量与配对统计

## 10.1 预实验

先做至少5对New-Baseline配对实验。每一对尽量由同一踩踏者、同一鞋子、同一位置、相近时间和相近最大位移完成。若5对波动很大，扩展到8-10对再估计样本量。预实验数据在满足同一正式流程和质量标准时可以计入最终样本，不必白白消耗压电片。

d_j = ΔE_New,j - ΔE_Baseline,j

s_d = √[ Σ(d_j-d̄)² / (n_pilot-1) ]

## 10.2 正式样本量估算

n ≈ [ (z_(1-α/2)+z_(1-β)) · s_d / Δ_min ]²

当 α=0.05、功效=0.80 时：n ≈ (2.80 · s_d / Δ_min)²

Δ_min是预先设定的最小有意义能量差，不能在看见最终结果后再选择。结果向上取整，并预留约10%给视频遮挡、触发失败或明显异常踩踏。正式次数可能是20对，也可能不是。

## 10.3 随机化与配对

- 每一对内部随机决定先New还是先Baseline，不使用固定ABAB。
- 实验前生成并锁定完整随机顺序，不能根据现场结果临时改变。
- 记录每次y_max和T_down；若某次明显偏离预设范围，应按预先制定的排除规则处理。
- 统计主分析使用配对差、配对t检验和95%置信区间；百分比提升率作为工程补充指标。

# 11. 减少压电片消耗的实验执行方案

所有实际踩踏都会让压电片发生弯曲并消耗一定疲劳寿命。关键不是把每项数据单独踩一遍，而是在同一次踩踏中同步获得尽可能多的数据。

批次 | 建议量 | 一次踩踏可同时获得
批次1：视频+开路波形 | New/Base各约5次 | 同步获得y_p(t)、y_m(t)、y_max、N_impact、T_d、A峰、V_peak与N_peak
批次2：整流桥+电容配对 | 先5对预实验，再按样本量补足 | 同步获得y_max、动作时间、N_impact、N_charge、V_before、V_after和ΔE
批次3：连续充电 | 每种结构建议3-5组，每组10-20步 | 获得V_initial、V_final、ΔE_total、P_net
批次4：负载/LED | 少量 | 电阻负载用于定量；LED仅演示

最伤压电片的通常不是合理范围内的几十或一百次重复，而是异常过载、撞击头偏心、局部刚性接触、海绵失效、边缘固定过紧或超过机械限位。实验前应设定安全行程，并在每批实验后检查裂纹、胶带松动和基线漂移。

# 12. 单次正式实验标准操作流程（SOP）

13. 检查8个模块装配、导向、弹簧位置、海绵状态和电路连接；记录结构为New或Baseline。
14. 确认上板回到初始高度；逐模块检查设计零间隙是否实际成立并记录异常。
15. 将储能电容放电或恢复到规定初始范围；记录真实V_before。
16. 启动示波器和同步视频，确保时间轴和实验编号一致。
17. 按照预先规定的随机顺序，由同一踩踏者在同一标记位置完成一次踩下-松开。
18. 保持装置静止，直到机械振动和电容台阶稳定；保存示波器原始CSV和视频。
19. 记录V_after、y_max、T_down、N_impact、N_charge及异常备注。
20. 按预先规则判断该试验是否有效；不得因为结果“不好看”而临时删除。
21. 恢复电容初始状态并检查压电片、胶带、海绵和弹簧是否松动，再进入下一次。

# 13. 建议的数据记录表

ID | 结构 | 顺序 | V_before(V) | V_after(V) | y_max(mm) | T_down(s) | N_impact | N_charge | 文件名 | 备注
1
2
3
4
5
6

建议每条记录同时保存：示波器CSV文件名、视频文件名、结构照片版本号和装配变更说明。任何更换压电片、海绵、弹簧或胶带的操作，都应开启新的实验批次，而不是与旧批次直接混合。

# 14. 结论判定逻辑

只有当下列证据同时成立时，才能把性能提升合理归因于多次分离-再撞击机制：

22. 视频确认New结构确实发生更多再撞击，而Baseline显著减少或消除再撞击。
23. 开路波形显示New结构具有与机械再撞击时刻对应的后续原始脉冲。
24. New结构的有效充电脉冲数或充电台阶更高，但不强制要求N_impact=N_charge。
25. 在相近y_max、相近动作时间和相同电路条件下，New结构的平均单次净电容储能更高。
26. 配对平均差的95%置信区间和p值支持差异不是由随机波动造成，同时效果大小达到预设Δ_min。
27. Baseline保持机构自身附加信号满足噪声和5%工程容许标准。

最终证据链：视频再撞击 + 开路多脉冲 + 电容净储能提升 + 公平配对Baseline

# 15. 正式测试前必须实测确认的现实细节

待确认项 | 为什么重要 | 确认方法
y_max≈25 mm是设计值还是实测值 | 影响行程、弹簧压缩和公平对比 | 侧视视频+标尺，分别记录设计值和实测值
8个模块实际初始间隙g_0,i | 装配公差会改变首次接触时刻 | 逐模块塞尺/纸片/侧视检查
大弹簧底端是否离底或滑移 | 决定1/3质量修正与固定端近似是否成立 | 在底端做标记并拍摄/实验后检查位移
阻尼比ζ是否足够小 | 决定能否使用简化质量反推公式 | 相邻峰幅值衰减计算ζ
压电片极性和同步性 | 避免8片并联相互抵消 | 逐片轻载抽查正负极性和主峰时序
Baseline保持件是否引入信号 | 防止对照组被额外碰撞污染 | 低幅/空载测试ΔV_C,fixture

# 16. 公式适用等级

等级 | 公式/内容 | 使用方式
主结果，可直接使用 | ΔE=1/2·C_F(V_after²-V_before²)；配对差、t检验、95%CI | 用于正式结论
机械解释，需注明假设 | F=kΔx；E_s=1/2kΔx²；阻尼自由振动；1/3弹簧质量修正 | 用于解释机制与参数校核
辅助趋势，不作精确预测 | Q=d_effF；开路V≈Q/C；1/2m_eqv_rel² | 不用于直接预测最终电容电压
必须靠实验而非公式决定 | 实际g_0、y_max、ζ、底端运动、波形同步性 | 先测量，再选择近似

# 17. 参考与方法边界

可参考：Selim, Yehia, Saleeb, “Energy Harvesting Floor Tile Using Piezoelectric Patches for Low-Power Applications,” Journal of Vibration Engineering & Technologies, 12, 8613-8622 (2024), DOI: 10.1007/s42417-024-01379-z。该论文可用于参考等效电路、整流/倍压测试和实验呈现方式，但其机械结构、压电数量和研究问题与本项目不同，不应直接作为Primary Baseline。

本报告采用“降复杂度、保执行性”的降阶模型：不做完整有限元、不求解完整非线性接触-压电耦合电路。公式用于组织物理逻辑和计算实测量；最终结论必须由同步视频、开路波形、储能电容和公平配对统计共同支持。

# 附录A：最小可执行检查清单

- 完成结构尺寸、质量、弹簧刚度、压电电容和储能电容实测。
- 完成8片极性和并联同步性抽查。
- 确认实际y_max、8个g_0,i、大弹簧底端状态和ζ。
- 搭建并验证连续接触Baseline，确认ΔV_C,fixture满足判据。
- 完成New/Base开路波形与同步视频。
- 完成至少5对预实验并估计正式样本量。
- 执行预先锁定的随机配对顺序。
- 保存原始CSV、视频、装配照片和数据表。
- 计算ΔE、配对差、提升率、p值和95%置信区间。

压电地板弹簧-撞击能量采集系统｜理论模型与实验方案
