yuxuan-518/piezoelectric-floor-tile/simulation/v2/figures/measured_v3_candidate_map.png

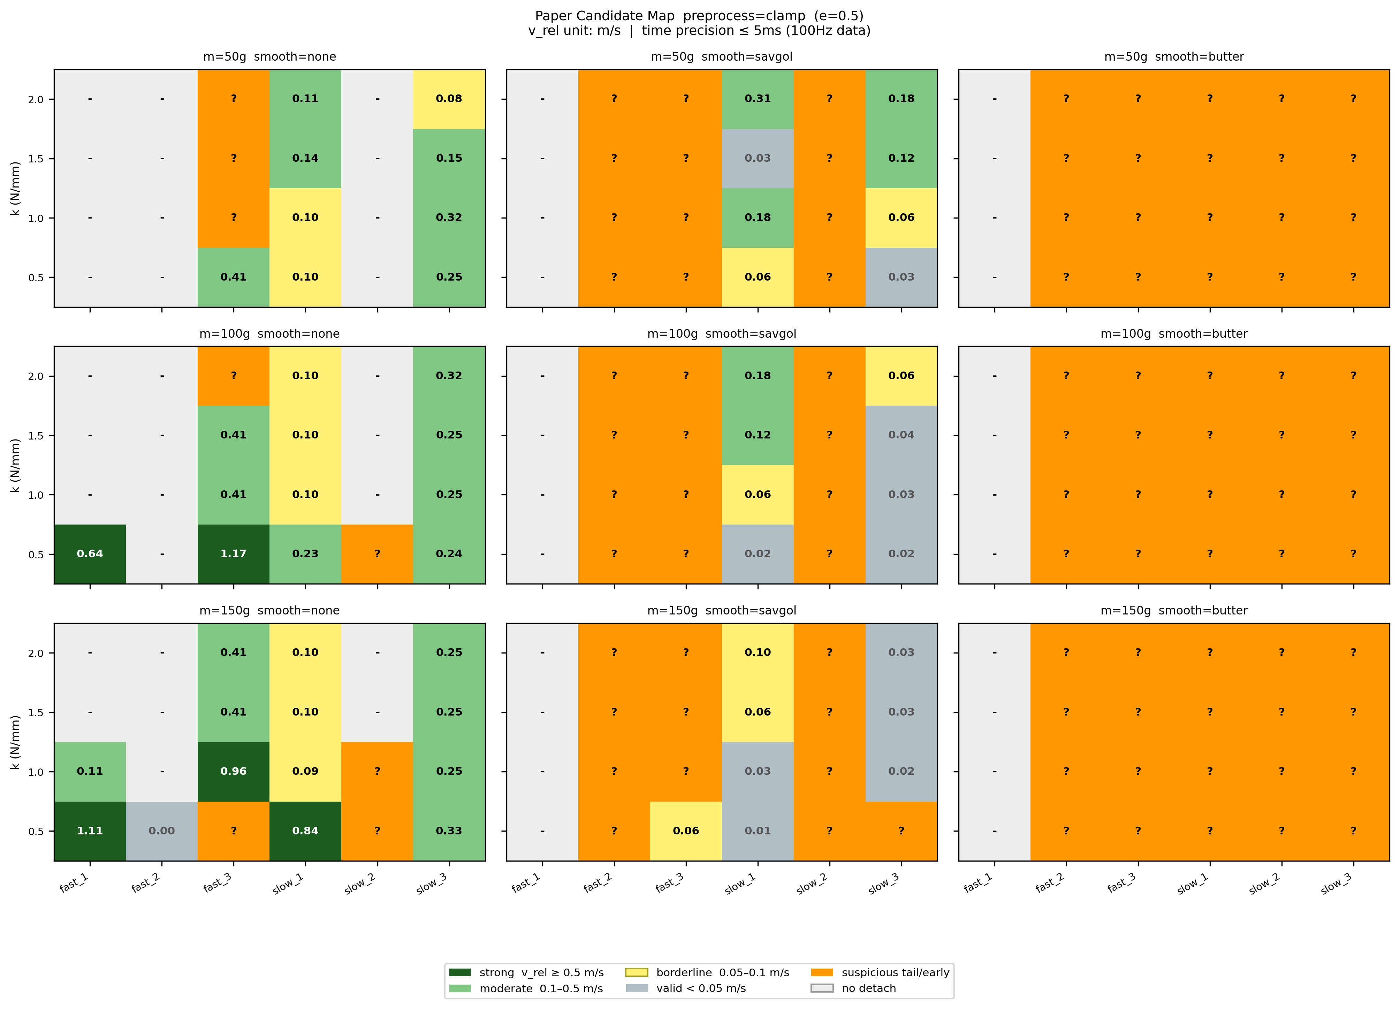
simulation/v2/figures/measured_v3_candidate_map.png
