yuxuan-518/piezoelectric-floor-tile/simulation/v2/figures/measured_v3_detach_map_clamp.png

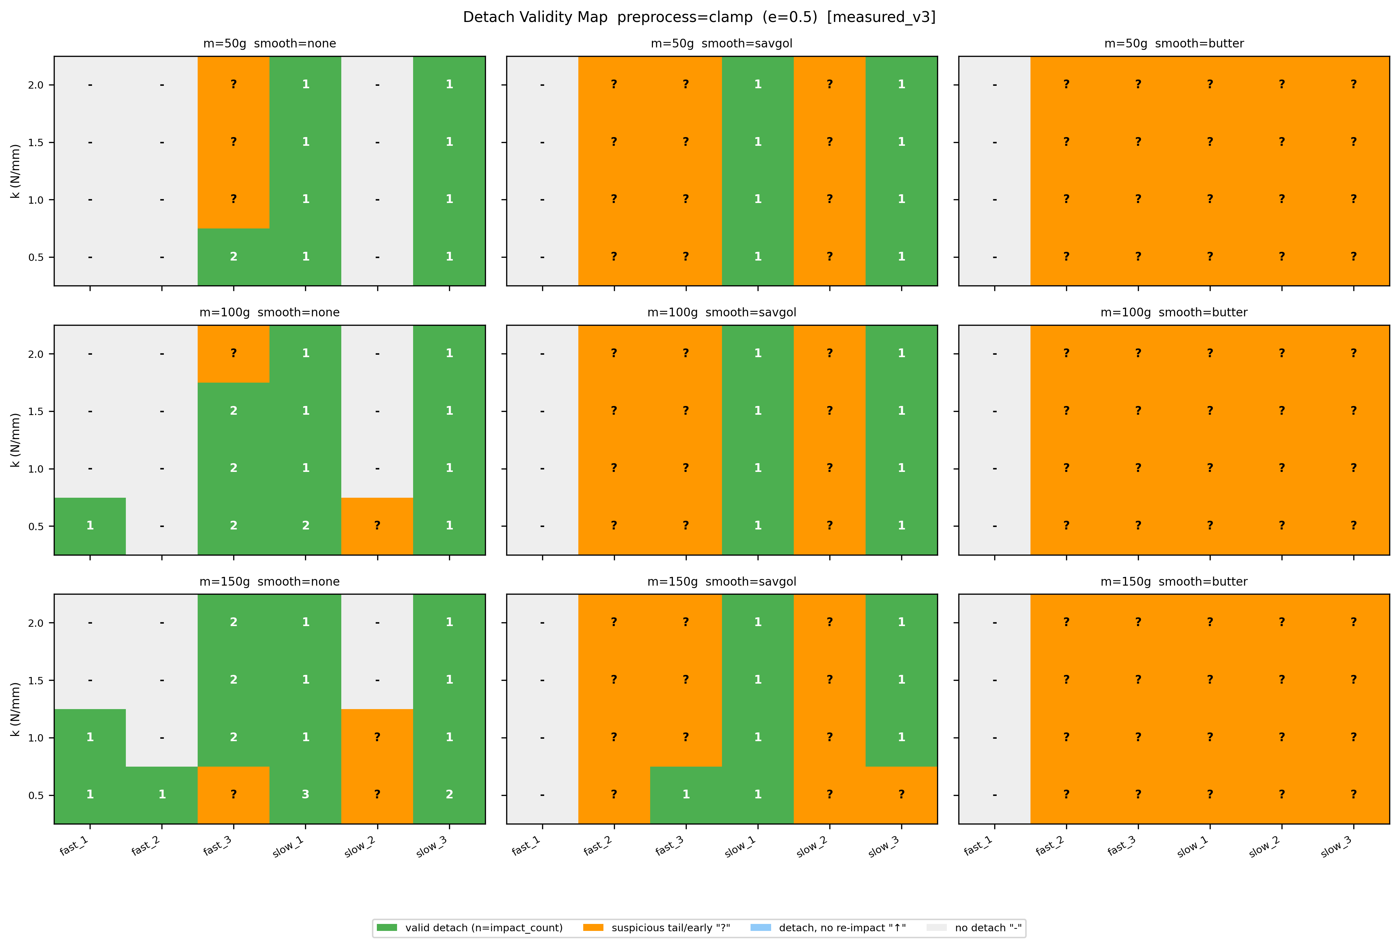
simulation/v2/figures/measured_v3_detach_map_clamp.png
