yuxuan-518/piezoelectric-floor-tile/simulation/v2/figures/measured_v3_raw_overview.png

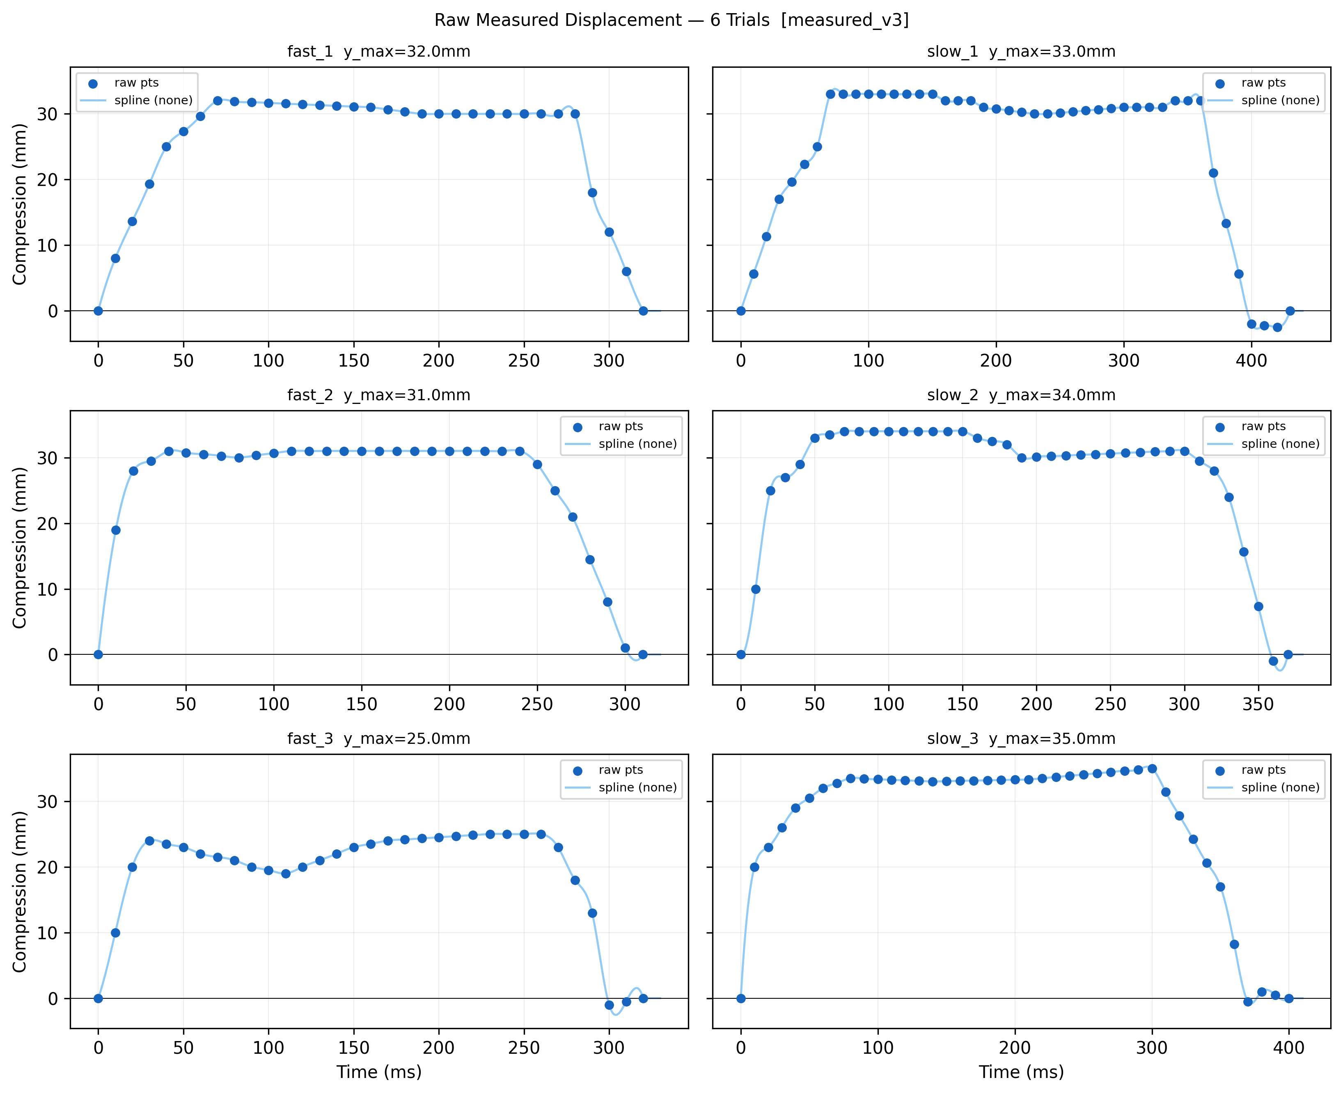
simulation/v2/figures/measured_v3_raw_overview.png
