yuxuan-518/piezoelectric-floor-tile/docs/process-reports/circuit-failure-and-troubleshooting-2026-06-01.docx

6.1 原型电路复刻实验报告

目标：

- 4个1n60p 二极管桥式整流电路
- 电容储能
- 尝试驱动黄色LED

材料清单：

材料 | 今天是否使用 | 作用/备注
压电陶瓷片 | 使用 | 受力变化时产生电压脉冲。红线通常接中间陶瓷片，黑线接外圈黄铜片。
1N60P 二极管 x4 | 使用 | 组成桥式整流，把 AC 脉冲变成单方向 DC 输出。有环端是 Cathode。
100uF / 25V 电解电容 | 使用 | 滤波/储能。长脚是正极；有条纹的一侧是负极。
150 ohm 电阻 | 使用 | 给电容安全放电；也可和 LED 串联限流。
黄色 LED | 尝试使用 | 大约需要 2V 左右并且需要足够电流。今天没有稳定点亮。
面包板 | 使用 | 中间区域同一数字行内 5 个孔相通。
万用表 | 使用 | 测导通、电阻、电压。

实验结果： 失败

原因分析猜测：

- 桥式整流某个二极管方向/节点错了。 你前面出现过“电容测到负值、跳动很乱、LED支路没电压”，这些都很像整流桥有一个节点接错，或者 AC、+、- 三个点混了。
- 面包板孔位理解偏差。 你用了 c10、i15、d2、d3、f5~j5 这些点，只要有一根跳线插到“看起来近但其实不通”的排，整个 LED 支路就断了。
- LED支路消耗太快。 100μF电容 + 150Ω + 黄色LED，会把压电片那点能量快速放掉。万用表能看到电压，但 LED 不一定亮，因为 LED 要的是足够电流。
- 压电片数量还是少。 论文是 14 个并联，你现在只有 4～5 个，而且还没做机械压紧结构，所以输出很不稳定。
- 万用表抓不到瞬间脉冲。 压电片电压是毫秒级尖峰，万用表刷新慢，所以你看到 0、1、4、12、25 乱跳，不代表真实波形。

下次 尝试方案：

## 方案A：先证明压电片组没问题

1. 不接二极管、不接电容、不接LED。
2. 5个压电片并联：所有红线接一起，所有黑线接一起。
3. 万用表调 V~ 交流电压。
4. 红笔接红线组，黑笔接黑线组。
5. 同时按/敲压电片。
6. 记录最高电压。

目标：确认压电片组本身能输出明显电压。

## 方案B：只测试桥式整流

1. 保持5个压电片并联。
2. 接入4个1N60P桥式整流。
3. 先不接电容、不接LED。
4. 万用表调 V⎓ 直流电压。
5. 红笔测整流桥 + 输出，黑笔测 - 输出。
6. 按/敲压电片。

目标：确认整流后输出永远是正值，不应该出现明显负值。

## 方案C：加入小电容储能

1. 只接：压电片组 → 桥式整流 → 100μF电容。
2. 电容正极接整流 +，负极接整流 -。
3. 万用表调 V⎓，测电容两端。
4. 先用150Ω电阻把电容放电到0V。
5. 敲压电片10次，记录电压。
6. 再敲10次，再记录。

目标：看到电容能被充电，而不是乱跳。

## 方案D：换不同电容比较

按同样接法分别测试：

1. 100μF
2. 2000μF
3. 4500μF

每次都先放电到0V，再敲相同次数，比如20次。

记录：电容大小 | 敲击次数 | 最终电压

目标：比较哪个电容最适合你的压电片数量。

## 方案E：最后才接LED

1. 先把电容充到至少 2V以上。
2. 接：整流+ → 150Ω电阻 → LED长脚 → LED短脚 → 整流-。
3. 黄色LED如果不亮，反过来试一次。
4. 如果仍不亮，说明电流不够，不是一定接错。

目标：验证是否能点亮或闪烁。

## 方案F：如果LED还是不亮

改用这个判断：

1. 不接LED。
2. 只看电容电压是否上升。
3. 如果电容能上升，实验成功一半。
4. 下一步增加压电片数量，目标从5个增加到10个以上。

材料需求：

压电片（20~30个）

二极管：1N60P（20个以上）

电阻：100Ω、150Ω、220Ω、330Ω、1kΩ、10kΩ

电容：1μF、10μF、47μF、100μF、220μF、470μF、1000μF、2000μF、4500μF、超级电容

LED：红色、黄色、绿色、蓝色、白色

开发板与模块：ESP32、INA219电流传感器、ADS1115 ADC模块、OLED显示屏、TP4056充电模块

连接材料：面包板、公对公跳线（50根以上）、鳄鱼夹线（10条以上）、红黑导线、USB供电线

焊接工具：电烙铁、焊锡丝、助焊剂/松香、热缩管、电工胶带

测量工具：万用表、示波器（FNIRSI DSO-TC3推荐）、示波器探头、游标卡尺、数字电子秤、尺子

机械结构材料：木板、亚克力板、EVA泡沫垫、双面胶、扎带

弹簧：软弹簧（10个）、中等弹簧（10个）、硬弹簧（10个）

辅助工具：镊子、小螺丝刀

记录与分析：实验记录本、Excel、Google Sheets

储能部分：锂电池、超级电容
