yuxuan-518/piezoelectric-floor-tile/(commit log)

2026-11-05 Organize floor-tile designs, A/B experiments, and project materials
    [center-punch-assembly.stl, fast_1.csv, fast_2.csv, fast_3.csv, historical-v1-v2-manifest.csv, impactor.stl, measured_v3_paper_candidates.csv, measured_v3_sim_sweep.csv]
2026-11-05 Clarify A/B controls and add formula review workbook
    [ab-formula-review-2026-11-05.xlsx]
2026-11-05 Fix capacitor unit spacing in GitHub math rendering
2026-11-08 Sync Shaoxuan Xiong contribution paragraph in README
    Use the approved English translation of Shaoxuan Xiong’s revised contribution paragraph.
2026-11-09 Add V3 prototype photograph IMG_7799
2026-11-09 Add V3 prototype photograph IMG_7800
2026-11-09 Add V3 prototype photograph IMG_7801
2026-11-09 Add assembled V3 prototype photograph 1
2026-11-09 Add assembled V3 prototype photograph 2
2026-11-09 Place assembled V3 photographs in readme
2026-11-09 Place assembled V3 photographs in index
2026-11-09 Clarify assembled photo location after gallery reorder
